icl-rocketry/Ricardo-Hermes/README.md

# Hermes - ICLR Radio Gateway board

ESP32c3 + SX1280 + SKY66112-11 Half-Duplex Lora radio gateway board.

## WIP!
