icl-rocketry/Ricardo-Hermes/Hardware/67794fb0744aabdc3f2668208d9ae6f6.webp

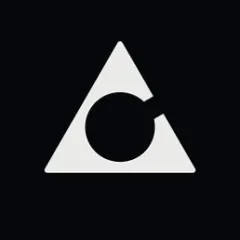
Hardware/67794fb0744aabdc3f2668208d9ae6f6.webp
