icl-rocketry/Ricardo-Hermes/Hardware/HermesArt.jpg

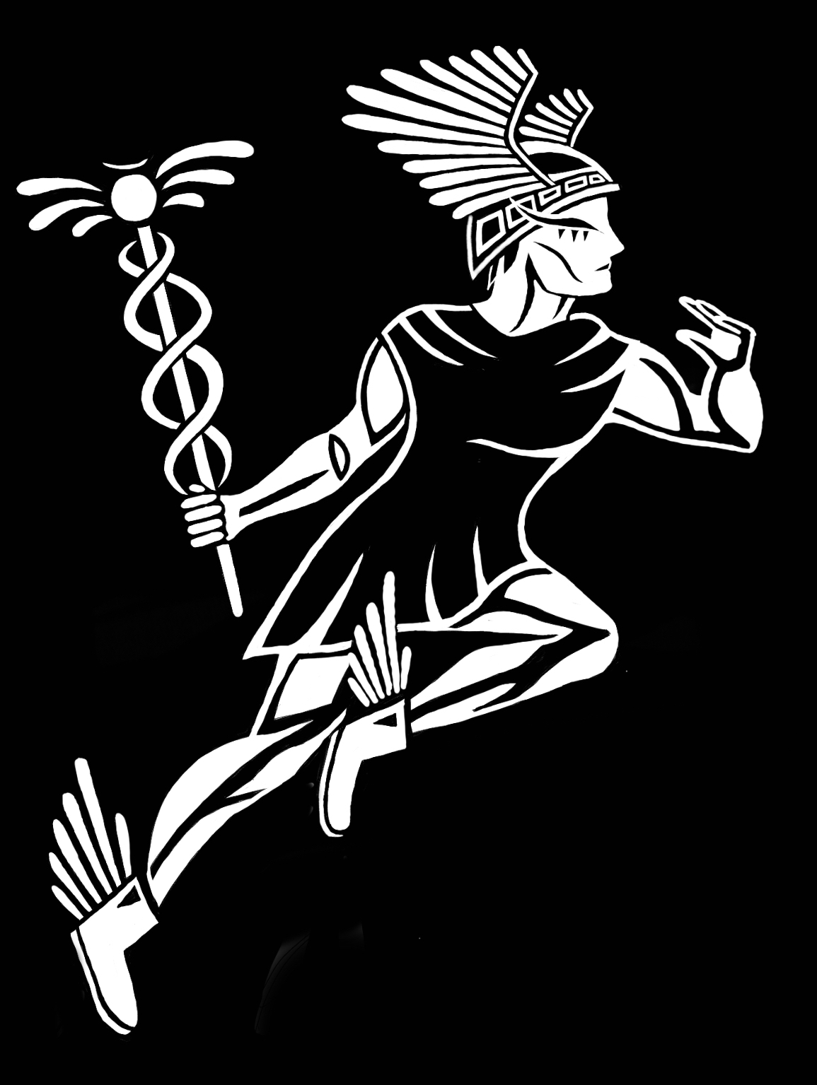
Hardware/HermesArt.jpg
