icl-rocketry/Ricardo-Hermes/Hardware/Ricardo-Hermes.kicad_pcb

## KiCad design Hardware/Ricardo-Hermes.kicad_pcb (2025-06-14)

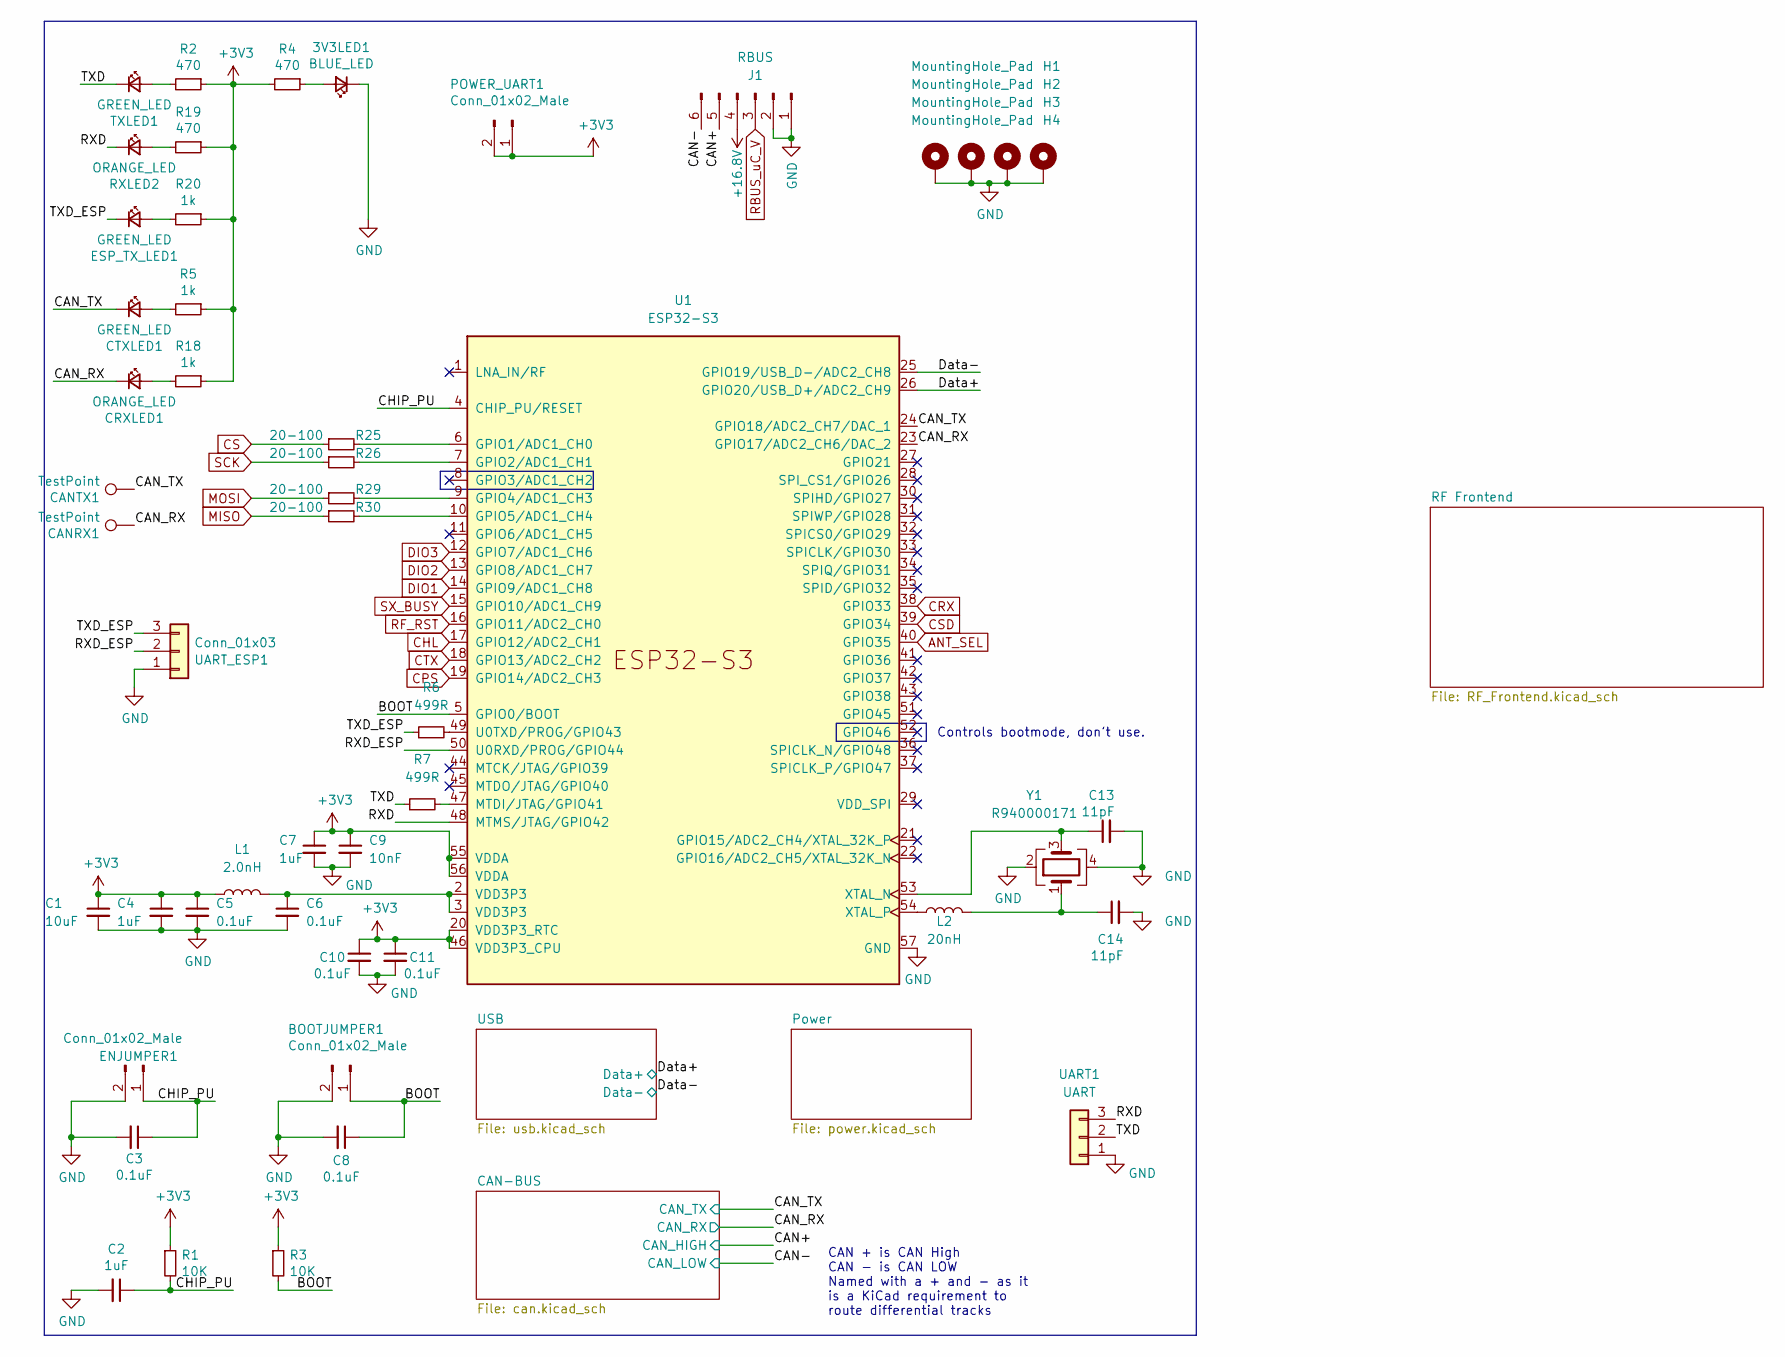
[picture p3: schematic Ricardo-Hermes.kicad_sch]

Parts:
3V3LED1: BLUE_LED; D_0402_1005Metric
BOOTJUMPER1: Conn_01x02_Male; PinHeader_1x02_P2.54mm_Vertical
C1: 10uF; C_0402_1005Metric
C2, C4, C7: 1uF; C_0402_1005Metric
C3, C5, C6, C8, C10, C11: 0.1uF; C_0402_1005Metric
C9: 10nF; C_0402_1005Metric
C13, C14: 11pF; C_0402_1005Metric
CANRX1: TestPoint; TestPoint_Pad_D1.0mm
CANTX1: TestPoint; TestPoint_Pad_D1.0mm
CRXLED1: ORANGE_LED; D_0402_1005Metric
CTXLED1: GREEN_LED; D_0402_1005Metric
ENJUMPER1: Conn_01x02_Male; PinHeader_1x02_P2.54mm_Vertical
ESP_TX_LED1: GREEN_LED; D_0402_1005Metric
H1, H2, H3, H4: MountingHole_Pad; MountingHole_3.2mm_M3_DIN965_Pad
J1: RBUS; Molex_Mini-Fit_Jr_5566-06A_2x03_P4.20mm_Vertical
L1: 2.0nH; L_0402_1005Metric
L2: 20nH; L_0402_1005Metric
POWER_UART1: Conn_01x02_Male; PinHeader_1x02_P2.54mm_Vertical
R1, R3: 10K; R_0402_1005Metric
R2, R4, R19: 470; R_0402_1005Metric
R5, R18, R20: 1k; R_0402_1005Metric
R6, R7: 499R; R_0402_1005Metric
R25, R26, R29, R30: 20-100; R_0402_1005Metric
RXLED2: ORANGE_LED; D_0402_1005Metric
TXLED1: GREEN_LED; D_0402_1005Metric
U1: ESP32-S3; QFN40P700X700X90-57N
UART1: UART; Molex_Nano-Fit_105313-xx03_1x03_P2.50mm_Horizontal
UART_ESP1: Conn_01x03; PinHeader_1x03_P2.54mm_Vertical
Y1: R940000171; Crystal_SMD_2016-4Pin_2.0x1.6mm

Connections:
+3V3: C1.1, C4.1, C5.1, C7.1, C9.1, C10.1, C11.1, L1.1, POWER_UART1.1, POWER_UART1.2, R1.1, R2.1, R3.1, R4.2, R5.1, R18.1, R19.1, R20.1, U1.20 (VDD3P3_RTC), U1.46 (VDD3P3_CPU), U1.55 (VDDA), U1.56 (VDDA); also elsewhere on the board
+16.8V: J1.4
/BOOT: BOOTJUMPER1.1, C8.1, R3.2, U1.5 (GPIO0/BOOT)
/CAN+: J1.5; also elsewhere on the board
/CAN-: J1.6; also elsewhere on the board
/CAN_RX: CANRX1.1, CRXLED1.1 (K), U1.23 (GPIO17/ADC2_CH6/DAC_2); also elsewhere on the board
/CAN_TX: CANTX1.1, CTXLED1.1 (K), U1.24 (GPIO18/ADC2_CH7/DAC_1); also elsewhere on the board
/CHIP_PU: C2.1, C3.1, ENJUMPER1.1, R1.2, U1.4 (CHIP_PU/RESET)
/Data+: U1.26 (GPIO20/USB_D+/ADC2_CH9); also elsewhere on the board
/Data-: U1.25 (GPIO19/USB_D-/ADC2_CH8); also elsewhere on the board
/RXD: RXLED2.1 (K), U1.48 (MTMS/JTAG/GPIO42), UART1.3
/RXD_ESP: U1.50 (U0RXD/PROG/GPIO44), UART_ESP1.2
/TXD: R7.1, TXLED1.1 (K), UART1.2
/TXD_ESP: ESP_TX_LED1.1 (K), R6.1, UART_ESP1.3
ANT_SEL: U1.40 (GPIO35); also elsewhere on the board
CHL: U1.17 (GPIO12/ADC2_CH1); also elsewhere on the board
CPS: U1.19 (GPIO14/ADC2_CH3); also elsewhere on the board
CRX: U1.38 (GPIO33); also elsewhere on the board
CS: R25.1; also elsewhere on the board
CSD: U1.39 (GPIO34); also elsewhere on the board
CTX: U1.18 (GPIO13/ADC2_CH2); also elsewhere on the board
DIO1: U1.14 (GPIO9/ADC1_CH8); also elsewhere on the board
DIO2: U1.13 (GPIO8/ADC1_CH7); also elsewhere on the board
DIO3: U1.12 (GPIO7/ADC1_CH6); also elsewhere on the board
GND: 3V3LED1.1 (K), BOOTJUMPER1.2, C1.2, C2.2, C3.2, C4.2, C5.2, C6.2, C7.2, C8.2, C9.2, C10.2, C11.2, C13.2, C14.2, ENJUMPER1.2, H1.1, H2.1, H3.1, H4.1, J1.1, J1.2, U1.57 (GND), UART1.1, UART_ESP1.1, Y1.2, Y1.4; also elsewhere on the board
MISO: R30.1; also elsewhere on the board
MOSI: R29.1; also elsewhere on the board
unnamed: 3V3LED1.2 (A), R4.1
unnamed: C6.1, L1.2, U1.2 (VDD3P3), U1.3 (VDD3P3)
unnamed: C14.1, L2.2, Y1.1
unnamed: CRXLED1.2 (A), R18.2
unnamed: CTXLED1.2 (A), R5.2
unnamed: ESP_TX_LED1.2 (A), R20.2
unnamed: R19.2, RXLED2.2 (A)
unnamed: R2.2, TXLED1.2 (A)
unnamed: R25.2, U1.6 (GPIO1/ADC1_CH0)
unnamed: R26.2, U1.7 (GPIO2/ADC1_CH1)
unnamed: R29.2, U1.9 (GPIO4/ADC1_CH3)
unnamed: R30.2, U1.10 (GPIO5/ADC1_CH4)
unnamed: R7.2, U1.47 (MTDI/JTAG/GPIO41)
unnamed: R6.2, U1.49 (U0TXD/PROG/GPIO43)
unnamed: C13.1, U1.53 (XTAL_N), Y1.3
unnamed: L2.1, U1.54 (XTAL_P)
RBUS_uC_V: J1.3; also elsewhere on the board
RF_RST: U1.16 (GPIO11/ADC2_CH0); also elsewhere on the board
SCK: R26.1; also elsewhere on the board
SX_BUSY: U1.15 (GPIO10/ADC1_CH9); also elsewhere on the board

Notes on the sheet:
Controls bootmode, don't use.
CAN + is CAN High CAN - is CAN LOW Named with a + and - as it is a KiCad requirement to route differential tracks

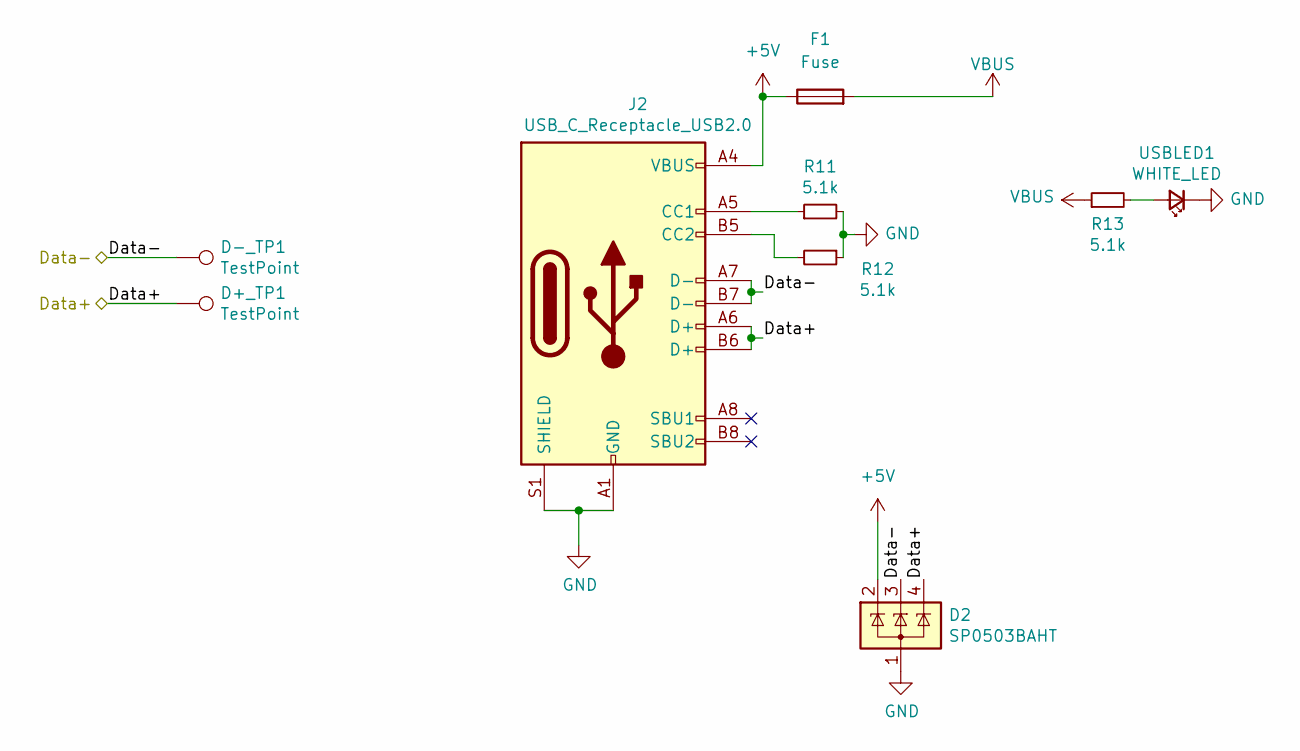
[picture p4: schematic usb.kicad_sch]

Parts:
D2: SP0503BAHT; SOT-143
D+_TP1: TestPoint; TestPoint_Pad_D1.0mm
D-_TP1: TestPoint; TestPoint_Pad_D1.0mm
F1: Fuse; Fuse_0603_1608Metric
J2: USB_C_Receptacle_USB2.0; USB_C_Receptacle_Palconn_UTC16-G
R11, R12, R13: 5.1k; R_0402_1005Metric
USBLED1: WHITE_LED; D_0402_1005Metric

Connections:
+5V: D2.2 (K), F1.1, J2.A4 (VBUS), J2.A9 (VBUS), J2.B4 (VBUS), J2.B9 (VBUS)
/Data+: D2.4 (K), D+_TP1.1, J2.A6 (D+), J2.B6 (D+); also elsewhere on the board
/Data-: D2.3 (K), D-_TP1.1, J2.A7 (D-), J2.B7 (D-); also elsewhere on the board
GND: D2.1 (A), J2.A1 (GND), J2.A12 (GND), J2.B1 (GND), J2.B12 (GND), J2.S1 (SHIELD), R11.2, R12.1, USBLED1.1 (K); also elsewhere on the board
unnamed: J2.A5 (CC1), R11.1
unnamed: J2.B5 (CC2), R12.2
unnamed: R13.2, USBLED1.2 (A)
VBUS: F1.2, R13.1; also elsewhere on the board

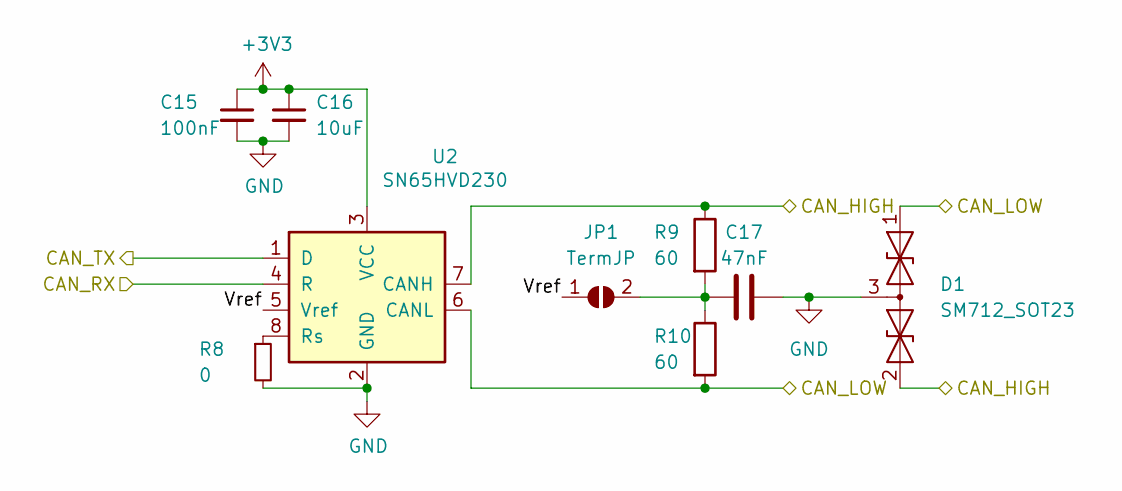
[picture p5: schematic can.kicad_sch]

Parts:
C15: 100nF; C_0402_1005Metric
C16: 10uF; C_0402_1005Metric
C17: 47nF; C_0402_1005Metric
D1: SM712_SOT23; SOT-23
JP1: TermJP; SolderJumper-2_P1.3mm_Open_RoundedPad1.0x1.5mm
R8: 0; R_0603_1608Metric
R9, R10: 60; R_0603_1608Metric
U2: SN65HVD230; SOIC-8_3.9x4.9mm_P1.27mm

Connections:
+3V3: C15.1, C16.1, U2.3 (VCC); also elsewhere on the board
/CAN+: D1.2 (A2), R9.1, U2.7 (CANH); also elsewhere on the board
/CAN-: D1.1 (A1), R10.2, U2.6 (CANL); also elsewhere on the board
/CAN-BUS/Vref: JP1.1 (A), U2.5 (Vref)
/CAN_RX: U2.4 (R); also elsewhere on the board
/CAN_TX: U2.1 (D); also elsewhere on the board
GND: C15.2, C16.2, C17.2, D1.3 (common), R8.2, U2.2 (GND); also elsewhere on the board
unnamed: C17.1, JP1.2 (B), R9.2, R10.1
unnamed: R8.1, U2.8 (Rs)

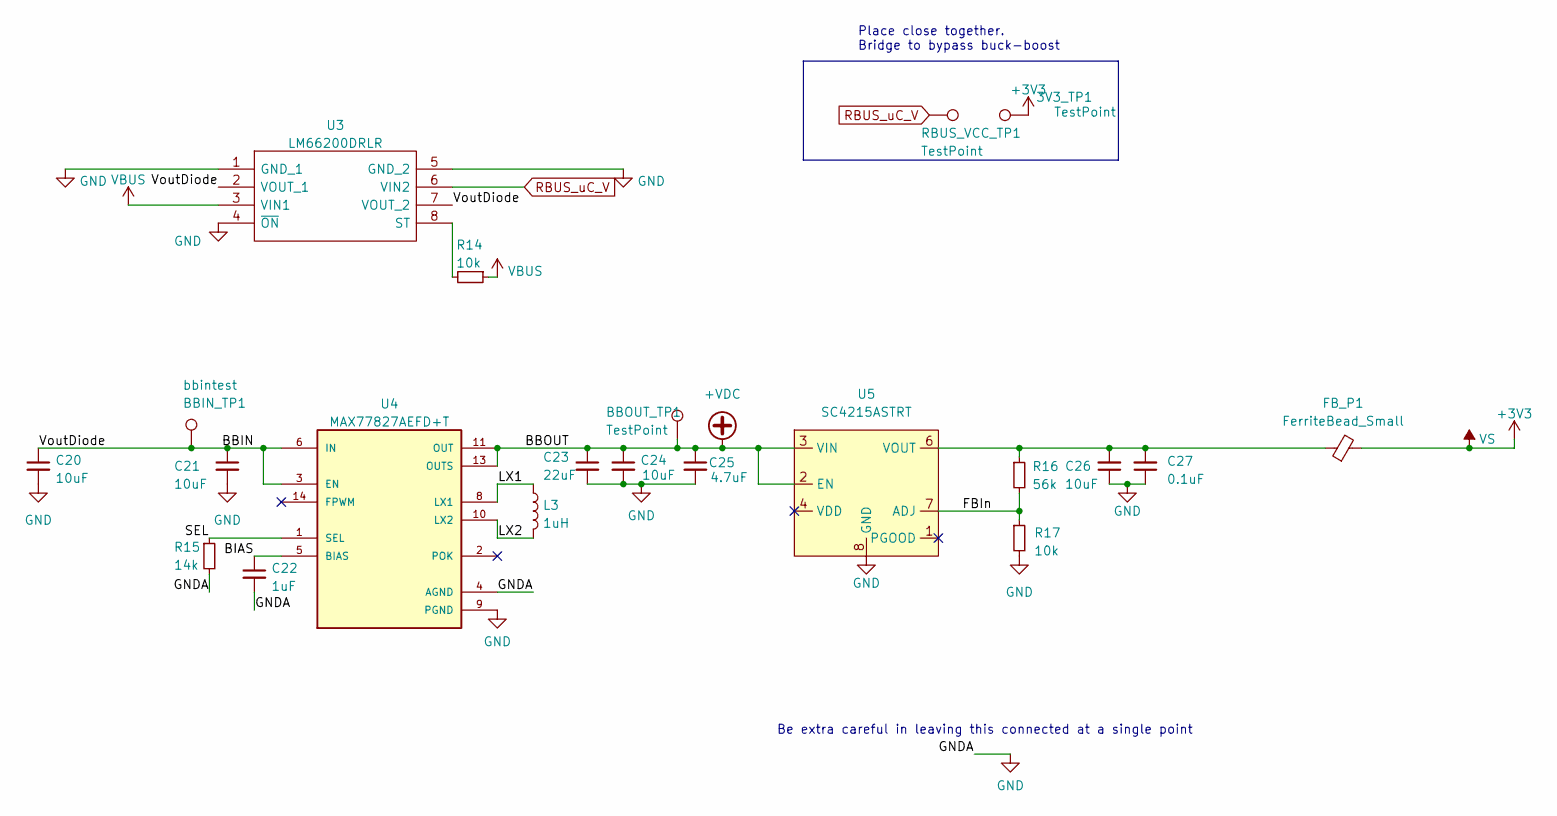
[picture p6: schematic power.kicad_sch]

Parts:
3V3_TP1: TestPoint; TestPoint_Pad_D1.5mm
BBIN_TP1: bbintest; TestPoint_Pad_D1.5mm
BBOUT_TP1: TestPoint; TestPoint_Pad_D1.5mm
C20, C24, C26: 10uF; C_0402_1005Metric
C21: 10uF; C_0603_1608Metric
C22: 1uF; C_0402_1005Metric
C23: 22uF; C_0603_1608Metric
C25: 4.7uF; C_0402_1005Metric
C27: 0.1uF; C_0402_1005Metric
FB_P1: FerriteBead_Small; L_0603_1608Metric
L3: 1uH; L_0805_2012Metric
R14, R17: 10k; R_0402_1005Metric
R15: 14k; R_0402_1005Metric
R16: 56k; R_0402_1005Metric
RBUS_VCC_TP1: TestPoint; TestPoint_Pad_D1.5mm
U3: LM66200DRLR; SOTFL50P160X60-8N; Manufacturer_Part_Number LM66200DRLR; Mouser Part Number 595-LM66200DRLR
U4: MAX77827AEFD+T; CONV_MAX77827AEFD+T; PARTREV B
U5: SC4215ASTRT; SOIC127P599X175-9N

Connections:
+3V3: 3V3_TP1.1, FB_P1.2; also elsewhere on the board
+VDC: BBOUT_TP1.1, C23.1, C24.1, C25.1, U4.11 (OUT), U4.13 (OUTS), U5.2 (EN), U5.3 (VIN)
/Power/BBIN: BBIN_TP1.1, C20.1, C21.1, U3.2 (VOUT_1), U3.7 (VOUT_2), U4.3 (EN), U4.6 (IN)
/Power/BIAS: C22.1, U4.5 (BIAS)
/Power/FBIn: R16.2, R17.1, U5.7 (ADJ)
/Power/LX1: L3.1, U4.8 (LX1)
/Power/LX2: L3.2, U4.10 (LX2)
/Power/SEL: R15.1, U4.1 (SEL)
GND: C20.2, C21.2, C22.2, C23.2, C24.2, C25.2, C26.1, C27.1, R15.2, R17.2, U3.1 (GND_1), U3.4 (~ON), U3.5 (GND_2), U4.4 (AGND), U4.9 (PGND), U5.8 (GND), U5.9 (GND); also elsewhere on the board
unnamed: R14.2, U3.8 (ST)
unnamed: C26.2, C27.2, FB_P1.1, R16.1, U5.6 (VOUT)
RBUS_uC_V: RBUS_VCC_TP1.1, U3.6 (VIN2); also elsewhere on the board
VBUS: R14.1, U3.3 (VIN1); also elsewhere on the board

Notes on the sheet:
Place close together. Bridge to bypass buck-boost
Be extra careful in leaving this connected at a single point

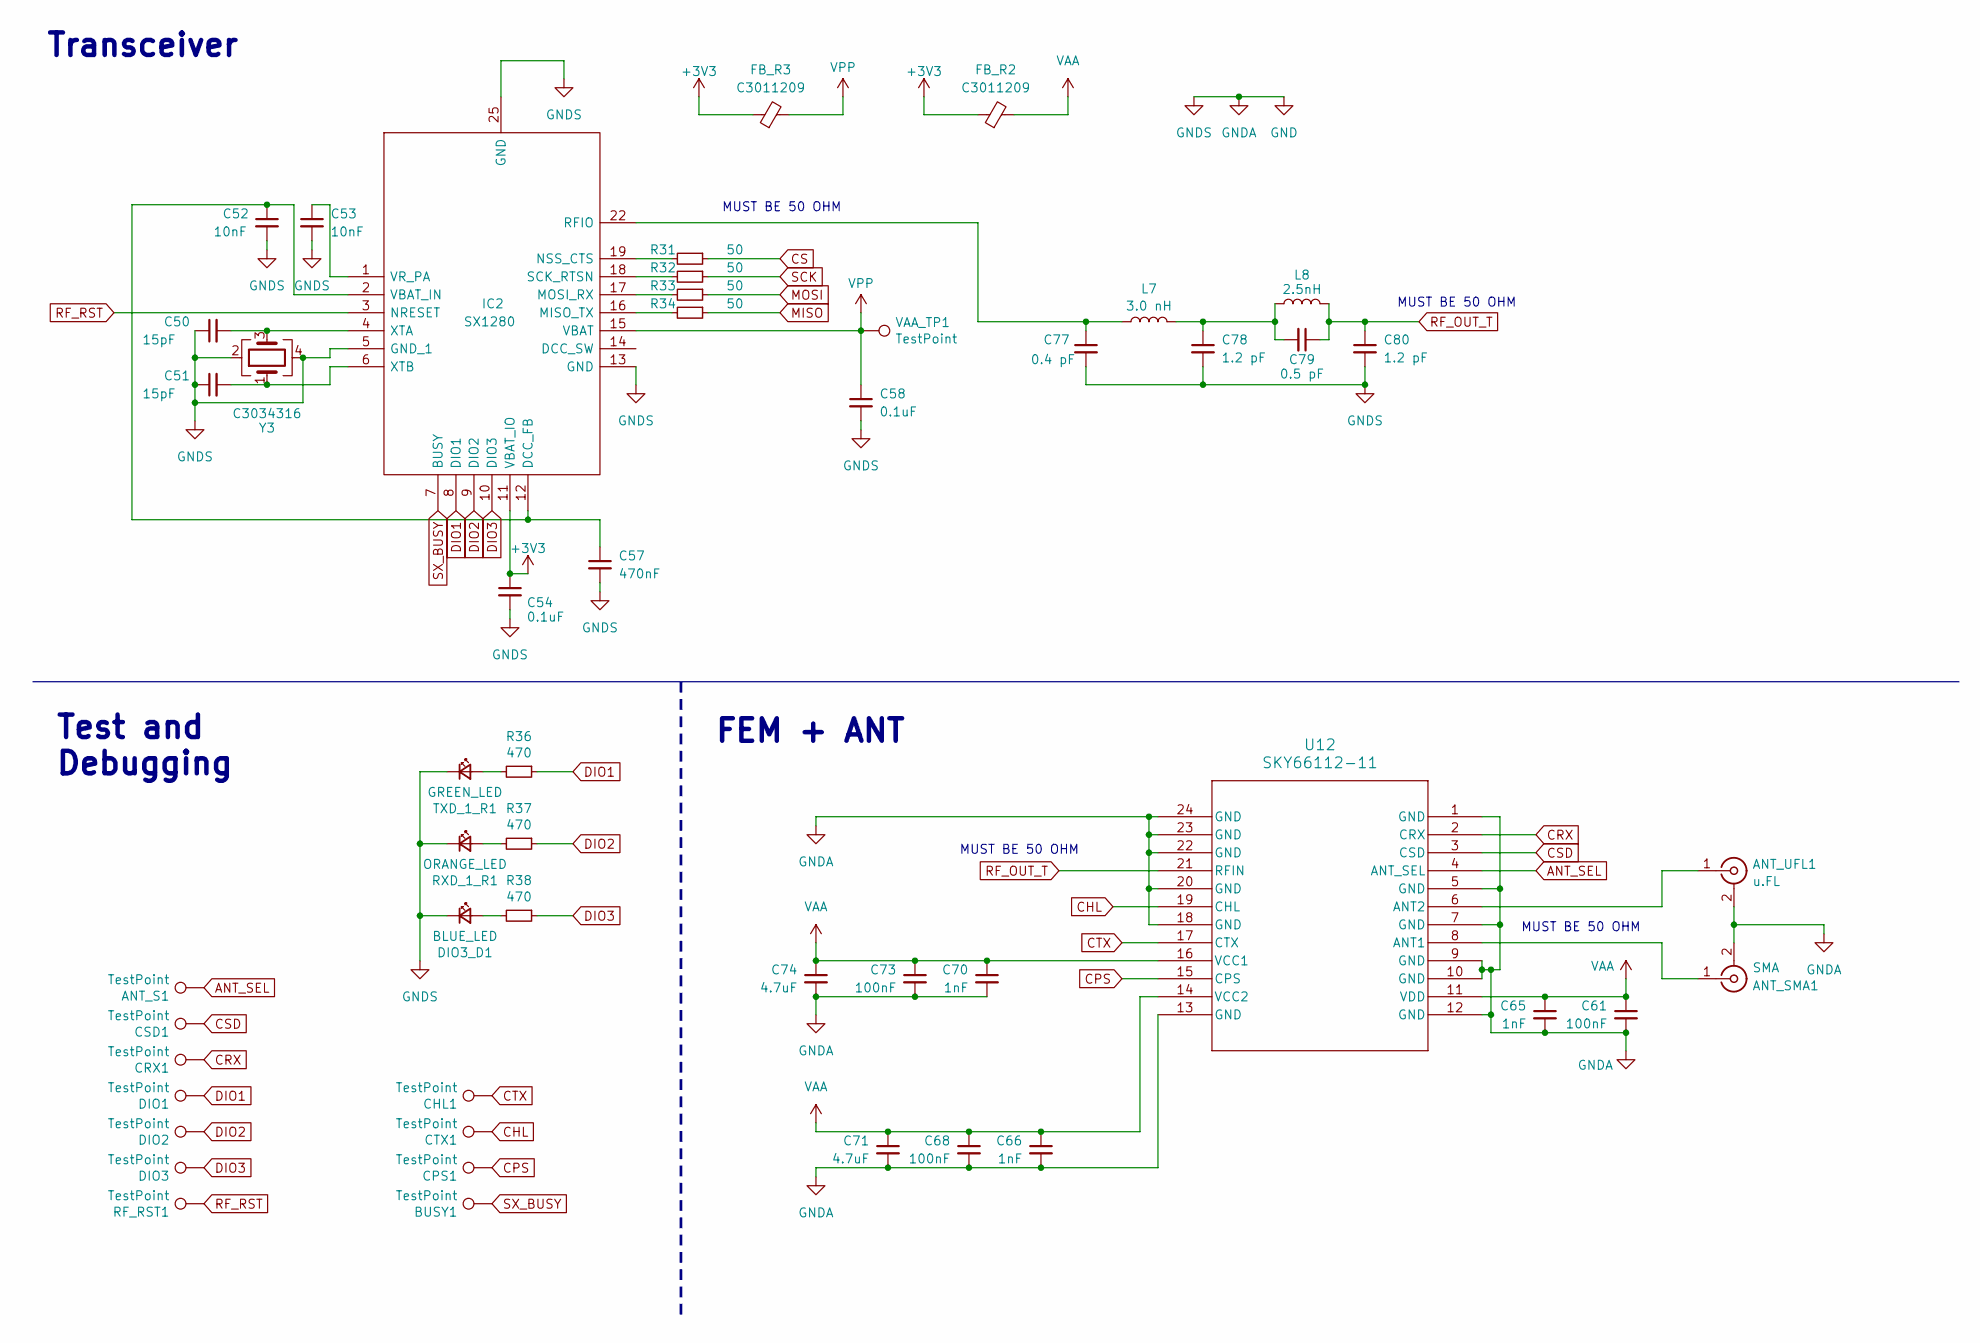
[picture p7: schematic RF_Frontend.kicad_sch]

Parts:
ANT_S1: TestPoint; TestPoint_Pad_D1.0mm
ANT_SMA1: SMA; SMA_Molex_73251-1153_EdgeMount_Horizontal
ANT_UFL1: u.FL; U.FL_Hirose_U.FL-R-SMT-1_Vertical
BUSY1: TestPoint; TestPoint_Pad_D1.0mm
C50, C51: 15pF; C_0402_1005Metric
C52, C53: 10nF; C_0402_1005Metric
C54, C58: 0.1uF; C_0402_1005Metric
C57: 470nF; C_0402_1005Metric
C61, C68, C73: 100nF; C_0402_1005Metric
C65, C66, C70: 1nF; C_0402_1005Metric
C71, C74: 4.7uF; C_0603_1608Metric
C77: 0.4 pF; C_0402_1005Metric
C78, C80: 1.2 pF; C_0402_1005Metric
C79: 0.5 pF; C_0402_1005Metric
CHL1: TestPoint; TestPoint_Pad_D1.0mm
CPS1: TestPoint; TestPoint_Pad_D1.0mm
CRX1: TestPoint; TestPoint_Pad_D1.0mm
CSD1: TestPoint; TestPoint_Pad_D1.0mm
CTX1: TestPoint; TestPoint_Pad_D1.0mm
DIO1, DIO2, DIO3: TestPoint; TestPoint_Pad_D1.0mm
DIO3_D1: BLUE_LED; D_0402_1005Metric
FB_R2, FB_R3: C3011209; L_0603_1608Metric
IC2: SX1280; QFN50P400X400X95-24N; Manufacturer_Part_Number SX1280IMLTRT; Mouser Part Number 947-SX1280IMLTRT
L7: 3.0 nH; L_0402_1005Metric
L8: 2.5nH; L_0402_1005Metric
R31, R32, R33, R34: 50; R_0402_1005Metric
R36, R37, R38: 470; R_0402_1005Metric
RF_RST1: TestPoint; TestPoint_Pad_D1.0mm
RXD_1_R1: ORANGE_LED; D_0402_1005Metric
TXD_1_R1: GREEN_LED; D_0402_1005Metric
U12: SKY66112-11; SKY66112-11_SKY
VAA_TP1: TestPoint; TestPoint_Pad_D1.0mm
Y3: C3034316; Crystal_SMD_2016-4Pin_2.0x1.6mm

Connections:
+3V3: C54.1, FB_R2.1, FB_R3.1, IC2.11 (VBAT_IO); also elsewhere on the board
ANT_SEL: ANT_S1.1, U12.4 (ANT_SEL); also elsewhere on the board
CHL: CTX1.1, U12.19 (CHL); also elsewhere on the board
CPS: CPS1.1, U12.15 (CPS); also elsewhere on the board
CRX: CRX1.1, U12.2 (CRX); also elsewhere on the board
CS: R31.1; also elsewhere on the board
CSD: CSD1.1, U12.3 (CSD); also elsewhere on the board
CTX: CHL1.1, U12.17 (CTX); also elsewhere on the board
DIO1: DIO1.1, IC2.8 (DIO1), R36.1; also elsewhere on the board
DIO2: DIO2.1, IC2.9 (DIO2), R37.1; also elsewhere on the board
DIO3: DIO3.1, IC2.10 (DIO3), R38.1; also elsewhere on the board
GND: ANT_SMA1.2 (Ext), ANT_UFL1.2 (Ext), C50.1, C51.1, C52.2, C53.2, C54.2, C57.2, C58.2, C61.2, C65.2, C66.2, C68.2, C70.2, C71.2, C73.2, C74.2, C77.2, C78.2, C80.2, DIO3_D1.1 (K), IC2.5 (GND_1), IC2.13 (GND), IC2.20 (GND), IC2.21 (GND), IC2.23 (GND), IC2.24 (GND), IC2.25 (GND), RXD_1_R1.1 (K), TXD_1_R1.1 (K), U12.1 (GND), U12.5 (GND), U12.7 (GND), U12.9 (GND), U12.10 (GND), U12.12 (GND), U12.13 (GND), U12.18 (GND), U12.20 (GND), U12.22 (GND), U12.23 (GND), U12.24 (GND), Y3.2, Y3.4; also elsewhere on the board
MISO: R34.1; also elsewhere on the board
MOSI: R33.1; also elsewhere on the board
unnamed: ANT_SMA1.1 (In), U12.8 (ANT1)
unnamed: ANT_UFL1.1 (In), U12.6 (ANT2)
unnamed: C78.1, C79.2, L7.2, L8.1
unnamed: DIO3_D1.2 (A), R38.2
unnamed: C52.1, C57.1, IC2.2 (VBAT_IN), IC2.12 (DCC_FB)
unnamed: IC2.16 (MISO_TX), R34.2
unnamed: IC2.17 (MOSI_RX), R33.2
unnamed: IC2.19 (NSS_CTS), R31.2
unnamed: C77.1, IC2.22 (RFIO), L7.1
unnamed: IC2.18 (SCK_RTSN), R32.2
unnamed: C53.1, IC2.1 (VR_PA)
unnamed: C50.2, IC2.4 (XTA), Y3.3
unnamed: C51.2, IC2.6 (XTB), Y3.1
unnamed: R37.2, RXD_1_R1.2 (A)
unnamed: R36.2, TXD_1_R1.2 (A)
RF_OUT_T: C79.1, C80.1, L8.2, U12.21 (RFIN)
RF_RST: IC2.3 (NRESET), RF_RST1.1; also elsewhere on the board
SCK: R32.1; also elsewhere on the board
SX_BUSY: BUSY1.1, IC2.7 (BUSY); also elsewhere on the board
VAA: C61.1, C65.1, C66.1, C68.1, C70.1, C71.1, C73.1, C74.1, FB_R2.2, U12.11 (VDD), U12.14 (VCC2), U12.16 (VCC1)
VPP: C58.1, FB_R3.2, IC2.15 (VBAT), VAA_TP1.1

Notes on the sheet:
MUST BE 50 OHM
Transceiver
Test and Debugging
FEM + ANT

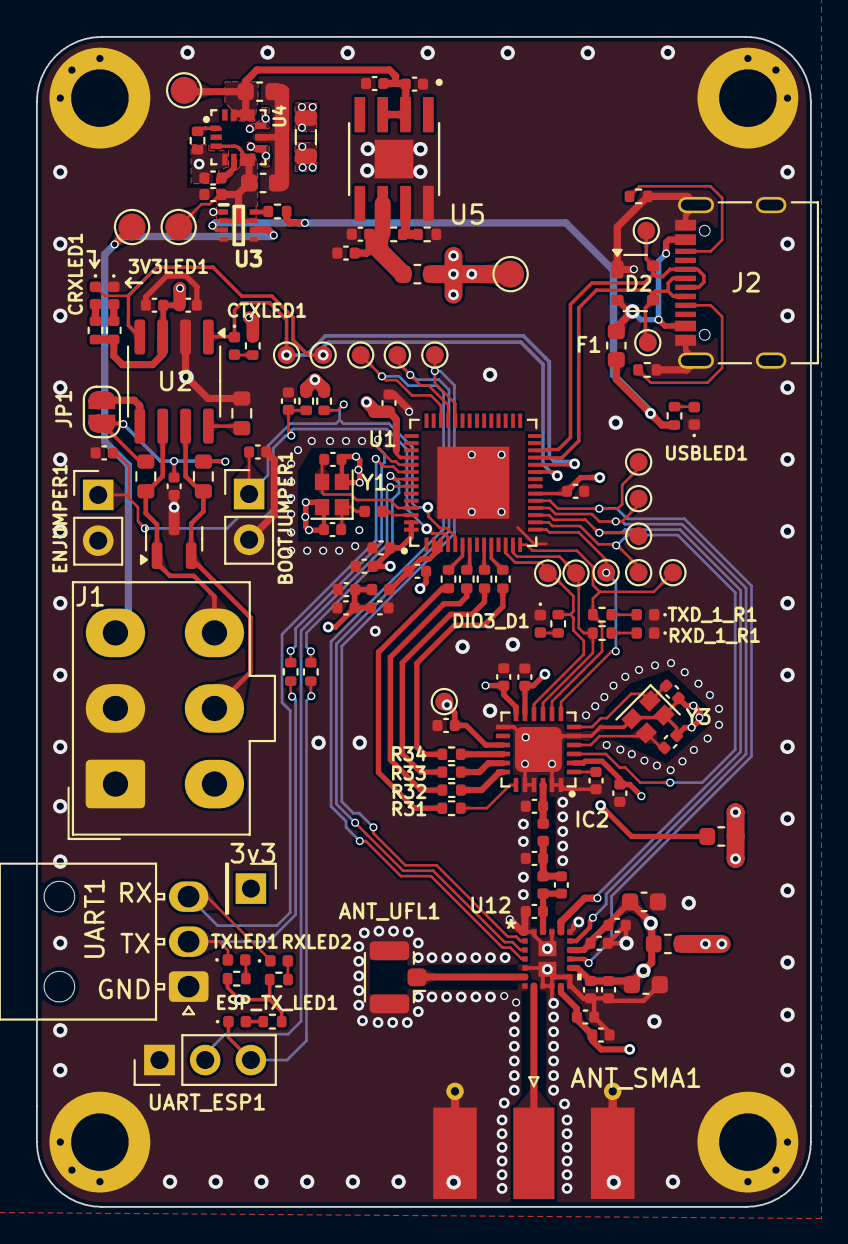
[picture p8: board Ricardo-Hermes.kicad_pcb from above]

Board: 4 copper layers, 43.0 x 65.0 mm, 138 parts (0 on the bottom side), 81 nets.

Other parts of the board:
3v3: Conn_01x02_Male; PinHeader_1x01_P2.54mm_Vertical

Their connections:
+3V3: 3v3.1; also elsewhere on the board
