icl-rocketry/Ricardo-Hermes/(commit log)

2024-11-24 Alpha revision
    [1053131102.stp, 12401598E4_2A.step, 21-0043D_8_MXM.step, 23Buckaroo v4.step, 26013144.stp, 2pinTerminal2.54.stp, 2pinTerminal3.5.STEP, 2pinnanofithorizontal.STEP]
2024-11-24 Fixed library assignment
    [RicardoTemplate.kicad_pcb]
2024-11-25 Added Faraday cage around PCB edge
    Less emi more betterer
    [RicardoTemplate.kicad_pcb]
2024-11-25 Changed UART connector
    Now with 1000% more nanofit!
    [RicardoTemplate.kicad_pcb, RicardoTemplate.kicad_sch]
2024-11-25 Changed uart conn
    Get transposed!
    [RF_Frontend.kicad_sch, RicardoTemplate.kicad_pcb, RicardoTemplate.kicad_sch]
2024-11-25 :D
    :D
    [RicardoTemplate.kicad_pcb]
2024-11-26 Changed via stitching
    [RF_Frontend.kicad_sch, RicardoTemplate.kicad_pcb]
2024-11-27 Minor improvements
    [RF_Frontend.kicad_sch, RicardoTemplate.kicad_pcb, RicardoTemplate.kicad_sch, usb.kicad_sch]
2024-11-28 Fixed Libraries
    [1053131102.stp, 12401598E4_2A.step, 21-0043D_8_MXM.step, 23Buckaroo v4.step, 26013144.stp, 2pinTerminal2.54.stp, 2pinTerminal3.5.STEP, 2pinnanofithorizontal.STEP]
2024-11-28 Minor changes
    [Ricardo-Hermes.kicad_pcb, Ricardo-Hermes.kicad_sch]
2024-12-09 Post review changes WIP
    [RF_Frontend.kicad_sch, Ricardo-Hermes.kicad_pcb, Ricardo-Hermes.kicad_sch, power.kicad_sch]
2024-12-09 Fixed minor issues
    [Ricardo-Hermes.kicad_pcb]
2024-12-10 Minor fixes
    [RF_Frontend.kicad_sch, Ricardo-Hermes.kicad_pcb, Ricardo-Hermes.kicad_sch]
2024-12-15 Silkscreen WIP
    [RF_Frontend.kicad_sch, Ricardo-Hermes.kicad_pcb]
2024-12-18 Final changes
    Art and BOM still need to be done
    [Ricardo-Hermes.kicad_pcb]
2024-12-31 Silkscreen changes
    [Ricardo-Hermes.kicad_pcb]
2025-01-21 Post Review changes, more to come...
    [RF_Frontend.kicad_sch, Ricardo-Hermes.kicad_pcb]
2025-01-22 Tidying up
    [RF_Frontend.kicad_sch, Ricardo-Hermes.kicad_pcb]
2025-03-06 Finishing touches without BOM
    [RF_Frontend.kicad_sch, Ricardo-Hermes.kicad_pcb, Ricardo-Hermes.kicad_sch, can.kicad_sch, power.kicad_sch, usb.kicad_sch]
2025-04-17 finishing changes
    [RF_Frontend.kicad_sch, Ricardo-Hermes.kicad_pcb, Ricardo-Hermes.kicad_sch, usb.kicad_sch]
2025-04-23 Prod Files
    [BOM-Ricardo-Hermes.csv, RF_Frontend.kicad_sch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]
2025-04-23 Final manu files
    Needs to be looked over
    [BOM-Ricardo-Hermes.csv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]
2025-04-24 Minor fix
    [Ricardo-Hermes.kicad_pcb]
2025-04-24 Went for a 3v3 plane
    [RF_Frontend.kicad_sch, Ricardo-Hermes.kicad_pcb, power.kicad_sch]
2025-04-25 Final changes and splitter prod files
    splitter repo tbd
    [BOM-Ricardo-Hermes.csv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]
2025-04-25 New leds
    [BOM-Ricardo-Hermes.csv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]
2025-04-25 Final fixes
    [BOM-Ricardo-Hermes.csv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]
2025-04-26 qr code
    [Ricardo-Hermes-CuBottom.gbr, Ricardo-Hermes-CuIn1.gbr, Ricardo-Hermes-CuIn2.gbr, Ricardo-Hermes-CuTop.gbr, Ricardo-Hermes-EdgeCuts.gbr, Ricardo-Hermes-MaskBottom.gbr, Ricardo-Hermes-MaskTop.gbr, Ricardo-Hermes-NPTH.drl]
2025-05-08 Forgot to push this silkscreen change
    [Ricardo-Hermes.kicad_pcb]
2025-06-14 PCB status: unfucked
    + sick art
    [RF_Frontend.kicad_sch, Ricardo-Hermes.kicad_pcb]
2025-06-14 added 3d
    [Ricardo-Hermes.kicad_pcb]
2025-07-16 Range test firmware + folder structure
    :)
    [BOM-Ricardo-Hermes.csv, RF_Frontend.kicad_sch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]
